Darkone83/XBOX-RGB/README.md

<div align=center>
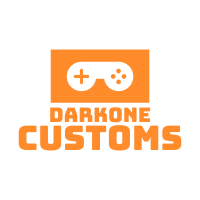
[picture p1: images/DC logo.png]
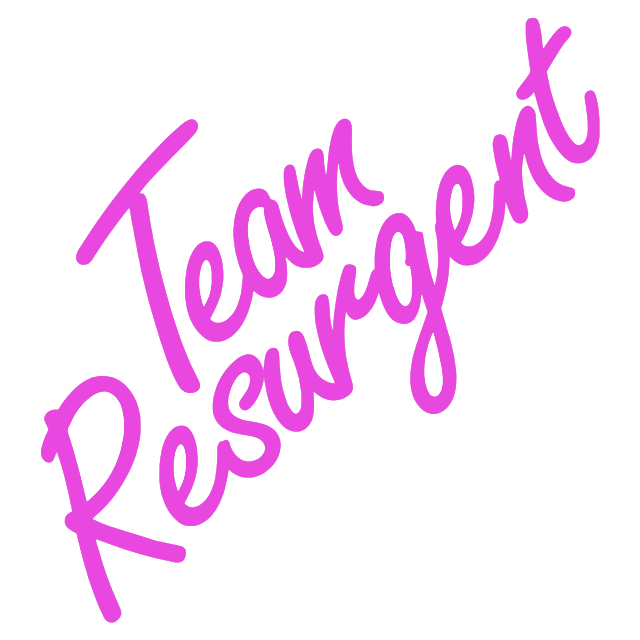
[picture p2: images/team-resurgent.png]
  
</div>

# XBOX RGB 

<div align=center>
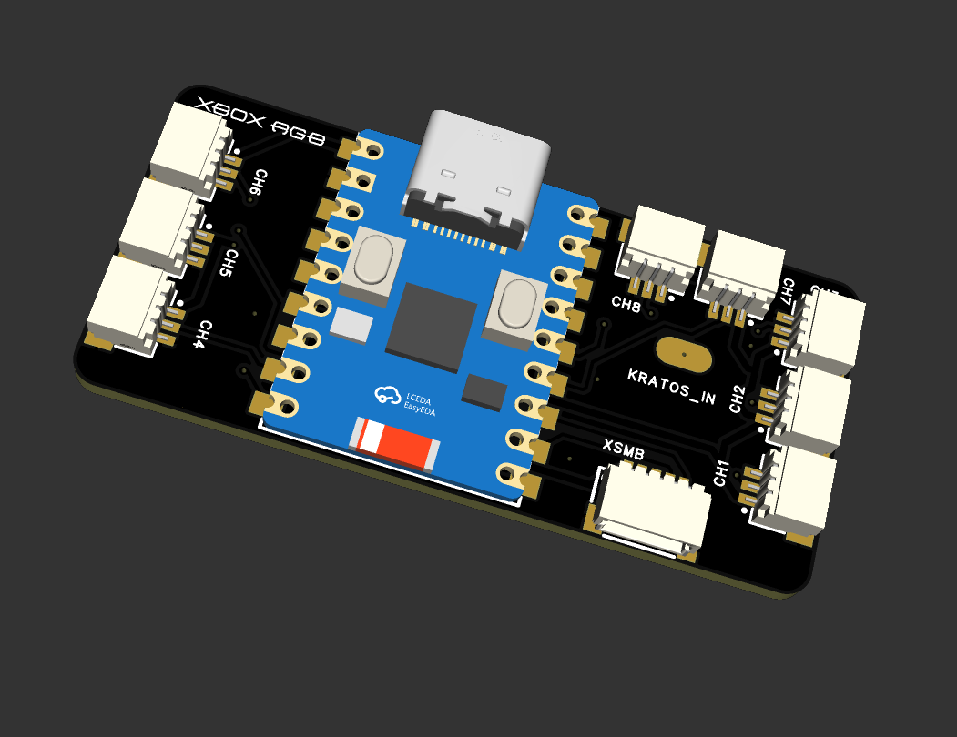
[picture p3: images/3D Front.png]
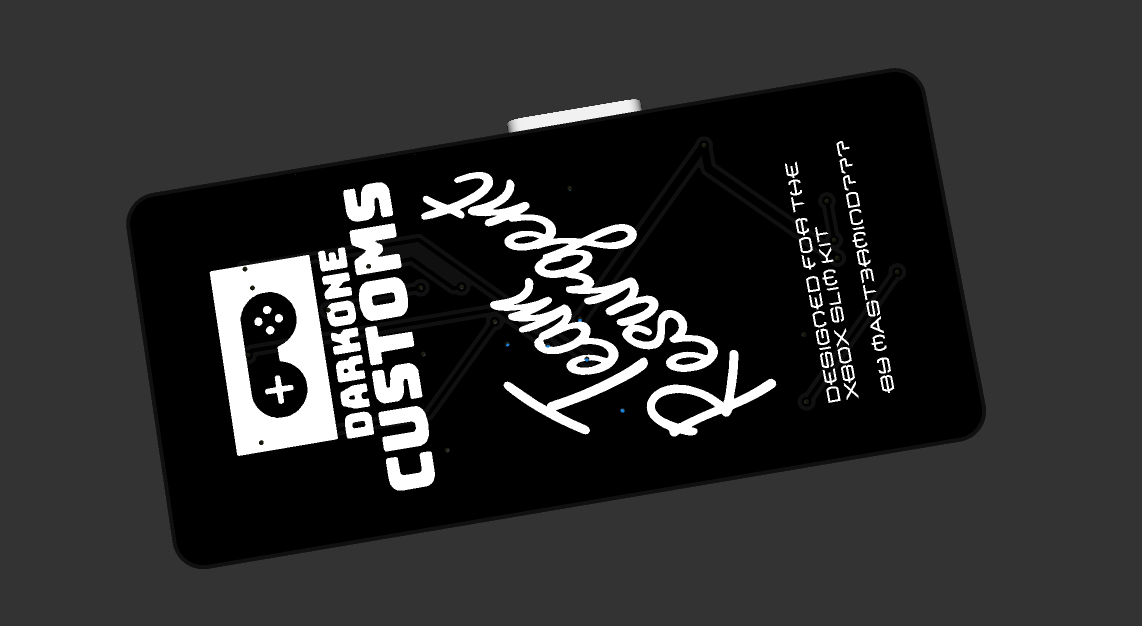
[picture p4: images/3D Back.png]
  

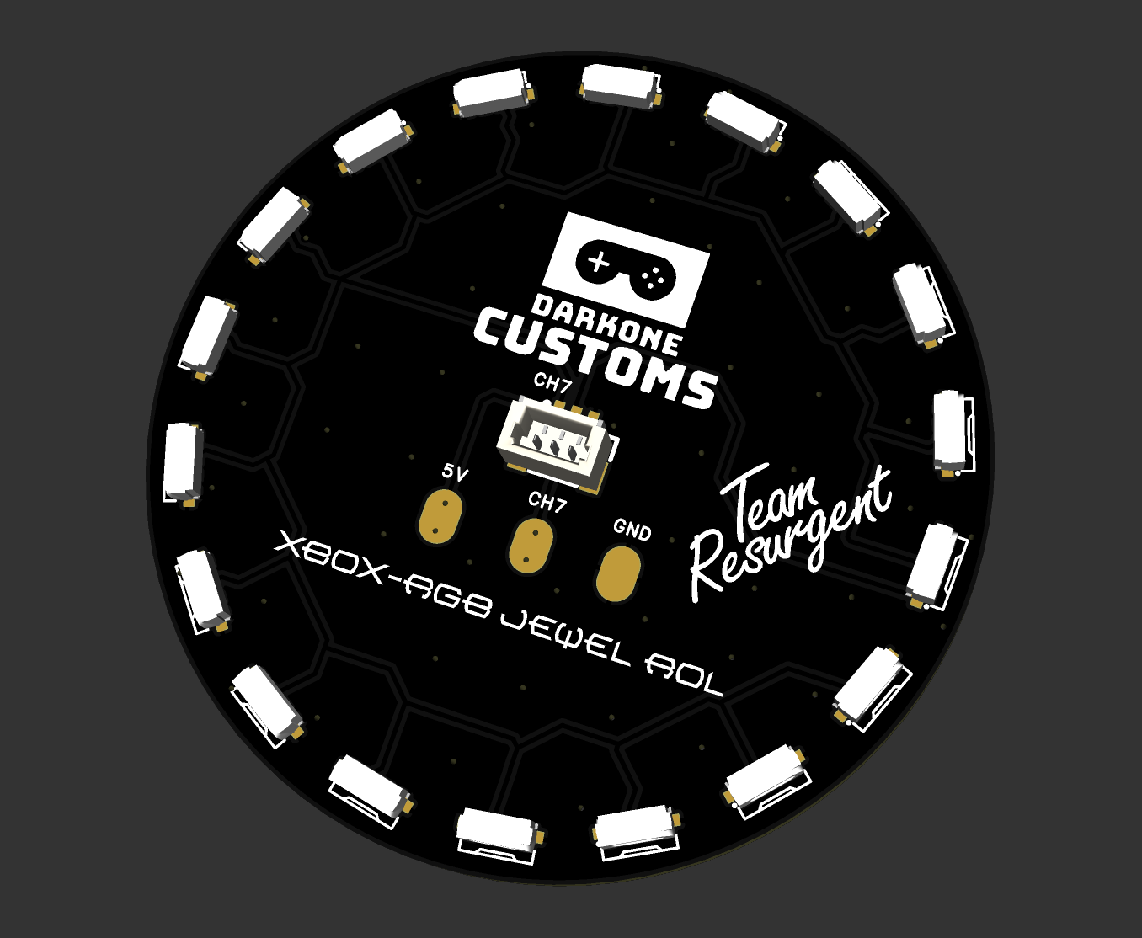
[picture p5: images/3D Jewel Front.png]
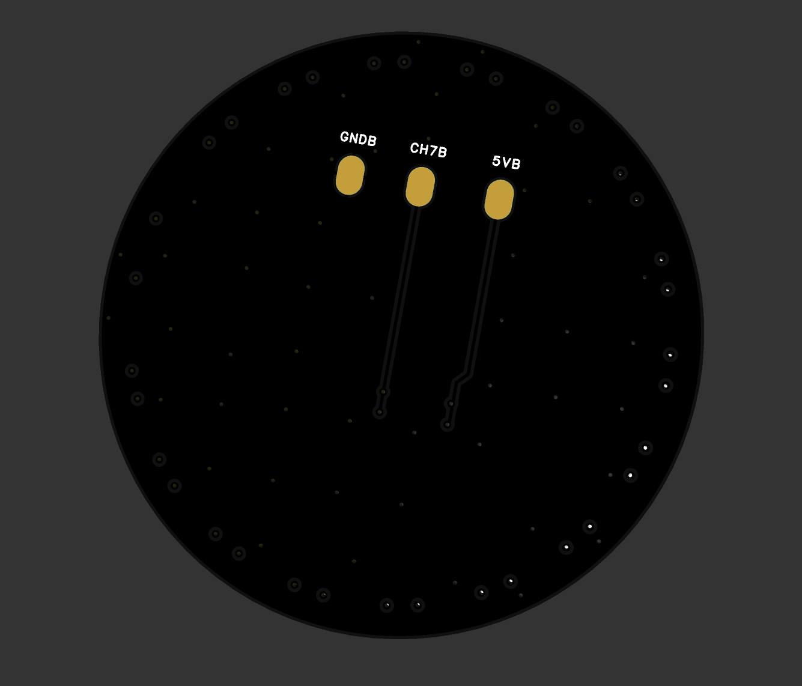
[picture p6: images/3D Jewel Back.png]
  
</div>



A custom RGB controller that drives up to **8 WS2812/NeoPixel channels** for original Xbox RGB lighting — with a **captive-portal Wi-Fi setup**, **web control UI**, **OTA updates**, and optional **Xbox SMBus** telemetry bars for **CPU temperature (CH5)** and **fan speed (CH6)**, **Jewel ROL CH7** and **CH8 for future espansion**.

- **CH1–CH4**: Main LED ring (up to **50 pixels per channel**).  
- **CH5**: CPU temperature bar (up to **10 pixels**).  
- **CH6**: Fan speed bar (up to **10 pixels**). 
- **CH7**: Jewel Ring of Light (ROL) **18 pixels**.
- **CH8**: Future Expansions. 

The web UI previews changes live and saves them to flash (NVS).

## 📱 Get the App

Download on the App Store (https://apps.apple.com/us/app/dc-rgb-control/id6755371794)

Download the **DC RGB Control** app for iOS to configure and manage your Darkone Customs RGB lighting hardware via BLE.

---

## Features

- ✨ **12 animation modes** (see below) with live preview
- 🔆 Global **brightness** (1–255)
-  💡 **Power on fade in** slow but gentle boot fdade in
- ⚙️ Per-mode controls: **Speed**, **Intensity**, **Width/Gap**, **Color A / Color B**
- 🧭 **Sane orientation & sync**: effects start at **CH1 (Front)** and flow clockwise **CH1→CH2→CH3→CH4→CH7→CH8**; all “phase” effects are synchronized
- 🪩 **Adjustable Strip length** CH1 - 4 can support up to 50 LEDs configurable from the webui
- 🔀 **Reversible channel support** Adjust the direction of your channels if you installed them backwards
- 💾 **Persistent settings** in NVS (counts, mode, colors, brightness, toggles…)
- 📶 **Wi-Fi portal** (AP SSID `XBOX RGB Setup`) with a sticky SSID picker
- 🌐 **Web UI** at `/config`
- 🔁 **OTA updates** at `/ota`
- 🧪 **SMBus (Xbox SMC) telemetry** (optional, on CH5/CH6)
  - **CPU temperature** bar (green→yellow→red, max 75 °C)
  - **Fan percentage** bar (blue→yellow→orange)
- 🛜 **UDP control** UDP comminucation and control for XBMC4Gamers and the PC app
- 🛜 **BLE control** BLE support for configuration and control (experemental).

---

## Animation Modes

1. **Solid**  
2. **Breathe** *(synced across all channels)*  
3. **Color Wipe**  
4. **Larson Scanner (Cylon)**  
5. **Rainbow** *(synced progression around the ring)*  
6. **Theater Chase**  
7. **Twinkle**  
8. **Comet**  
9. **Meteor** *(Color A→Color B trail)*  
10. **Clock Spin**  
11. **Plasma**  
12. **Fire / Flicker**
13. **Palette Cycle**
14. **Palette Chase**
15. **USNC <-> Covenant** **NEW**

> The UI only shows controls that matter for the selected mode.  
> Example: *Meteor* uses **Color A** and **Color B**; *Breathe* ignores **width**.

---

## Purchase:

<a href="https://www.darkonecustoms.com/store/p/xbox-rgb">Darkone Custsoms</a>

---

## Hardware

## Purchasing sources

ESP32 S3 Zero: <a href="https://www.amazon.com/dp/B0D1CB3PBW?ref_=ppx_hzsearch_conn_dt_b_fed_asin_title_1">Amazon</a>, <a href="https://www.aliexpress.us/item/3256808233319699.html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">Aliexpress</a>

JST Wire kit: <a href="https://www.amazon.com/dp/B0D5X6BY5Z?ref_=ppx_hzsearch_conn_dt_b_fed_asin_title_1">Amazon</a>

JST Socket kit: <a href="amazon.com/dp/B0CQ28CCQG?ref_=ppx_hzsearch_conn_dt_b_fed_asin_title_2">Amazon</a>

Additional wire may be needed to connect your harness to your LED strips.

## Hardware layout

Designed around **ESP32-S3-Zero** (or similar ESP32-S3 boards).

**Typical channel mapping** (adjust in code if needed):

- **CH1** → `IO1` (Front)  
- **CH2** → `IO2` (Left)  
- **CH3** → `IO3` (Rear)  
- **CH4** → `IO4` (Right)  
- **CH5** → `IO5` (CPU bar)  
- **CH6** → `IO6` (Fan bar)
- **CH7** → `IO10` (Jewel ROL)
- **Kratos_In** → `IO11` (Kratos Passthrough (Future Expansion))
- **CH8** → `IO12` (Future Expansions)

**SMBus (Xbox SMC I²C):**

- **SDA** → `IO7`  
- **SCL** → `IO8`

> If a strip is reversed physically, flip that channel via the `REVERSE[]` flags in `RGBCtrl.cpp`, or the WebUi.

---

## Pinouts

CH1 - 3:

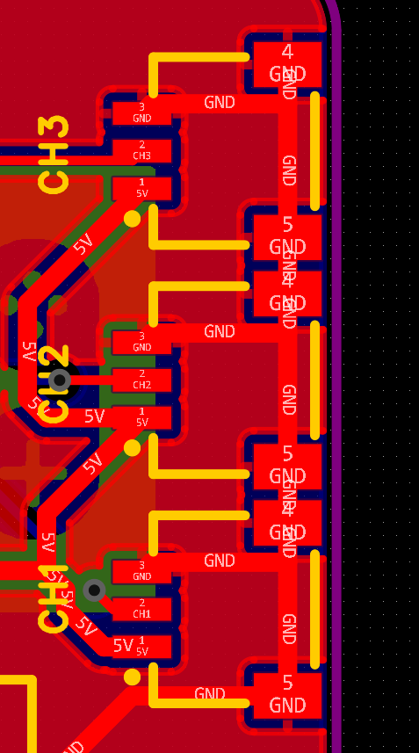
[picture p7: images/CH1-3.png]


Ch4 - 8:

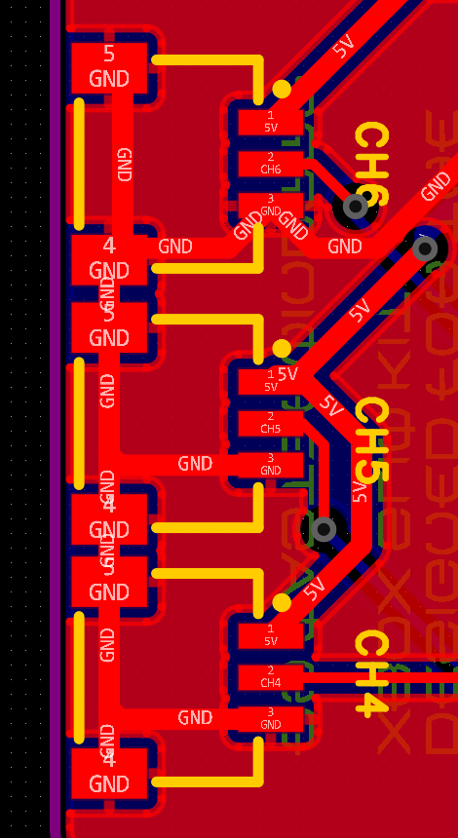
[picture p8: images/CH4-6.png]


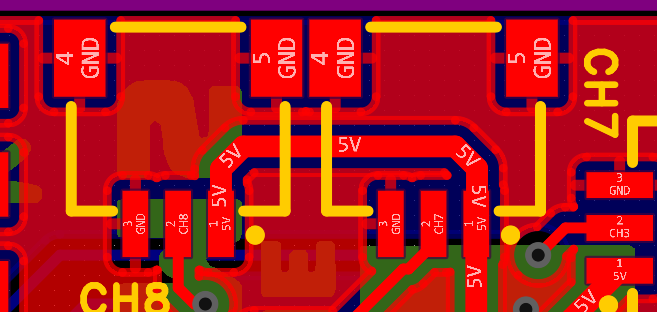
[picture p9: images/CH7-8.png]


XSMB:

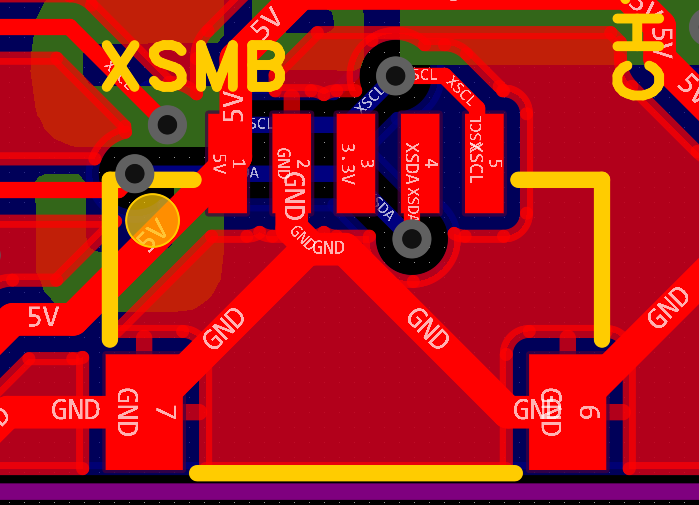
[picture p10: images/XSMB.png]


---

## Web UI

- Visit **`/config`** on the device to control animations.  
- **Live preview** applies instantly; **Save** writes to flash.  
- SMBus toggles (Enable CPU / Enable Fan) live under “Xbox SMBus LEDs”.

**Captive Portal:**  
On first boot (or after forgetting Wi-Fi) connect to AP **`XBOX RGB Setup`** → it redirects to the setup page.

**OTA:**  
Open **`/ota`**, pick your compiled `.bin`, upload, wait for reboot.

---

## Building / Compiling

#### Web Flasher: 

### Prerequisites

- **Arduino IDE 2.x** (or PlatformIO)
- **ESP32 board support** (Arduino-ESP32 **3.x**)
- Libraries:
  - **ESP Async WebServer** (me-no-dev)
  - **AsyncTCP** (ESP32)
  - **Adafruit NeoPixel**
  - **ArduinoJson**
  - Core: **Preferences**, **DNSServer**, **Update**

> Ensure AsyncTCP matches the ESP32 core version (latest works with Arduino-ESP32 3.x).

### Board Settings (typical)

- **Board:** `ESP32S3 Dev Module` (or your S3 variant)  
- **USB CDC On Boot:** Enabled  
- **PSRAM:** Optional  
- **Partition Scheme:** Minimal SPIFFS (1.9MB APP with OTA/190KB SPIFFS)

## Credits:
Hardware design: darkone83

Firmware: darkone83

3D Design / STLs: mast3rmind777

iOS App: darkone83

Android App: TechPhreak
