Darkone83/XBOX-RGB/stl/Readme.md

# XBOX-RGB Mount

STL creation and credit goes to Mast3rmind777
