Darkone83/XBOX-RGB/images/Back.png

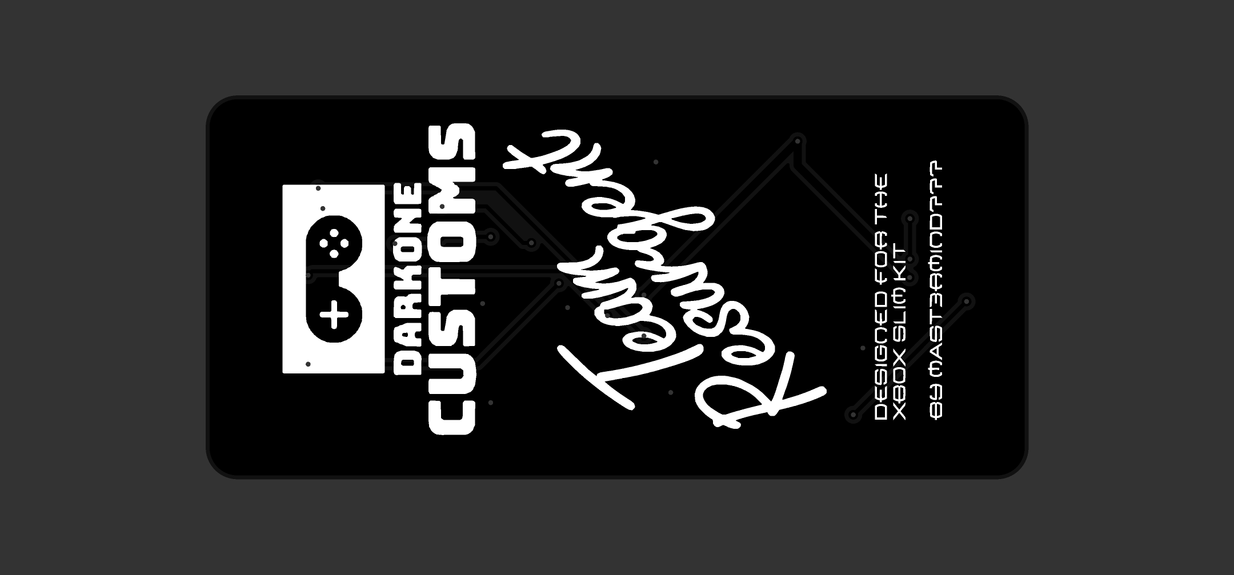
images/Back.png
