Darkone83/XBOX-RGB/images/Front.png

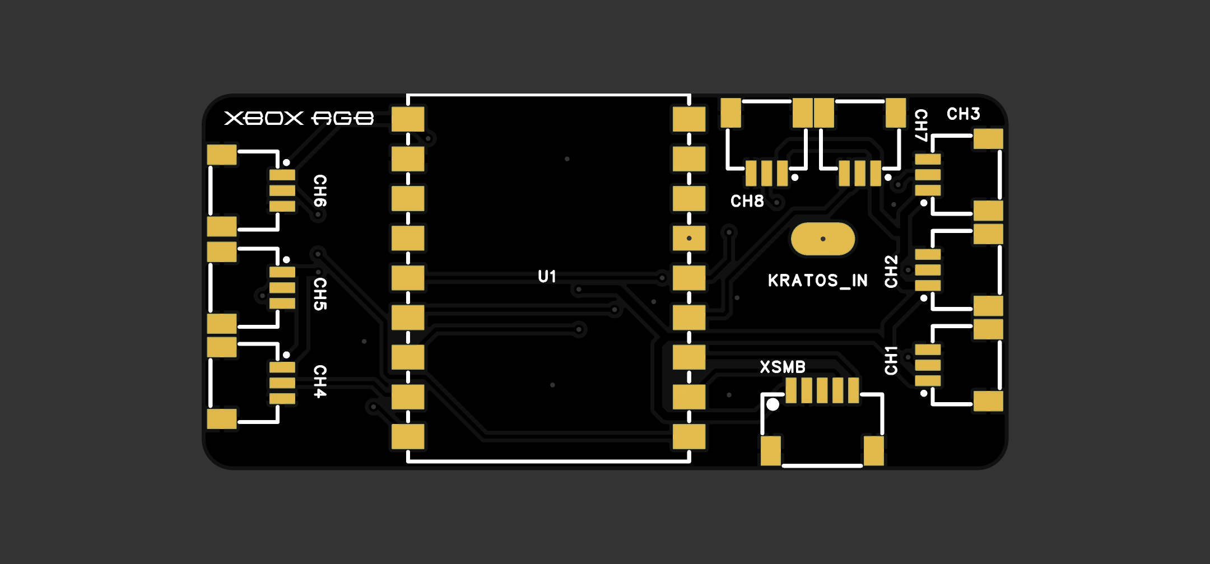
images/Front.png
