Darkone83/XBOX-RGB/images/Jewel Back.png

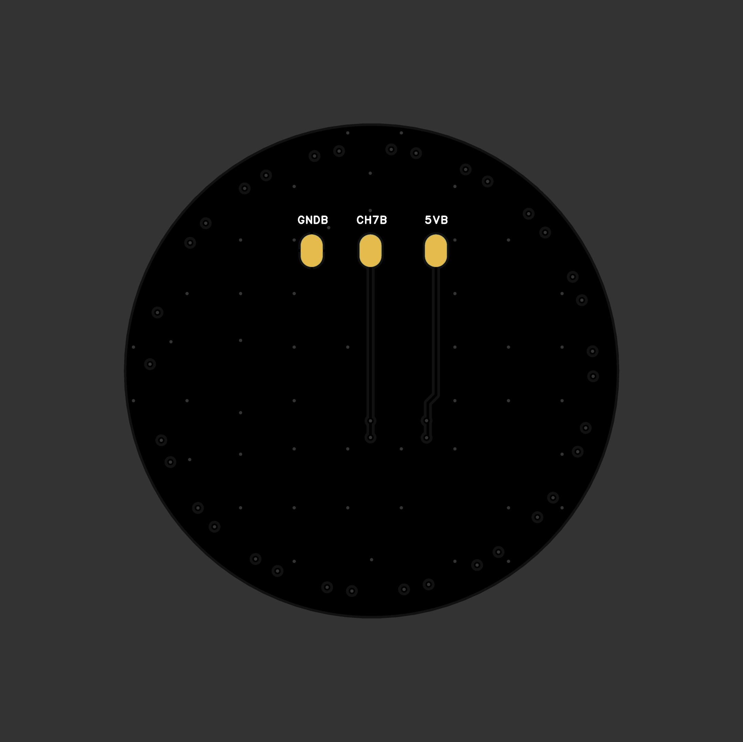
images/Jewel Back.png
