Darkone83/XBOX-RGB/images/Jewel Front.png

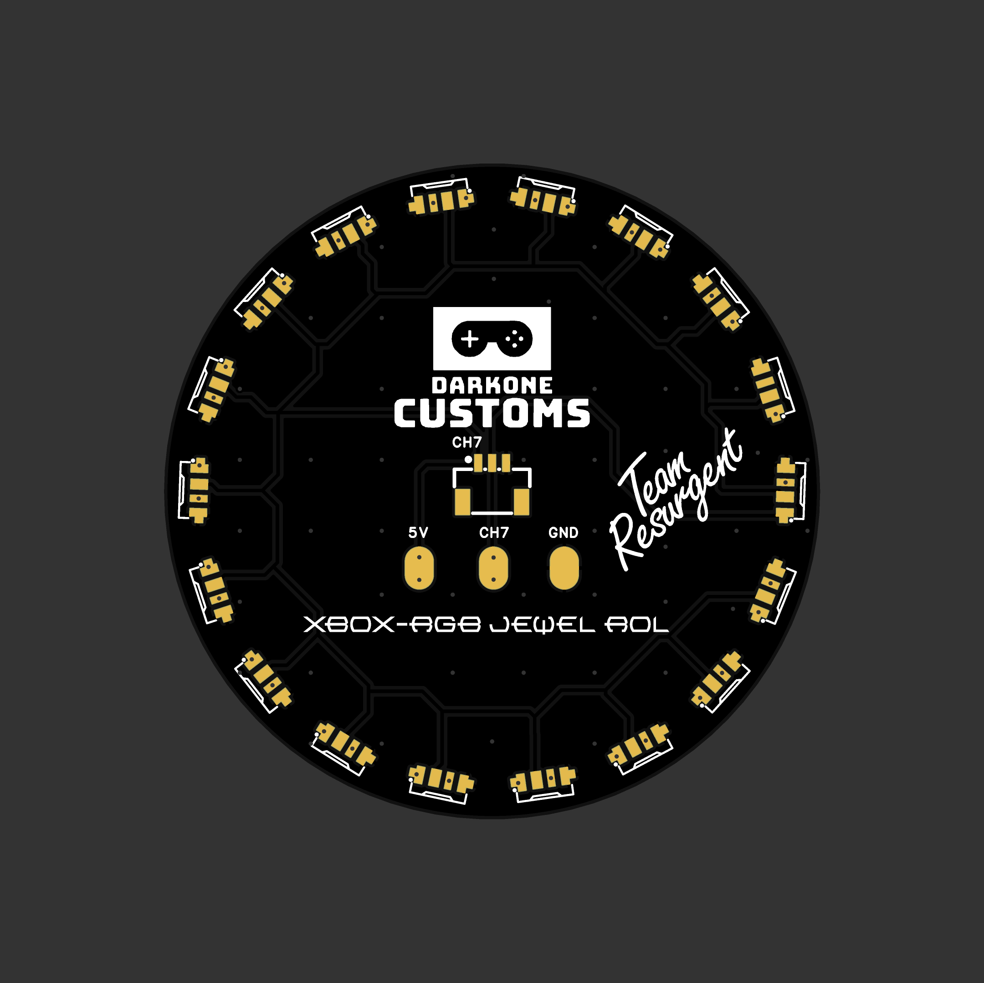
images/Jewel Front.png
