Darkone83/XBOX-RGB/jewel pcb/BOM.xlsx

No. | Quantity | Comment | Designator | Footprint | Value | Manufacturer Part | Manufacturer | Supplier Part | Supplier
1 | 6 | Test-Point | 5V,5VB,CH7,CH7B,GND,GNDB | Test-Point-0.5mm
2 | 1 | HC-1.0-3PLT | CH7 | CONN-SMD_3P-P1.00_HC-1.0-3PLT |  | HC-1.0-3PLT | HCTL(华灿天禄) | C2845371 | LCSC
3 | 18 | SK6812SIDE-A-RVS | RGB_LED1,RGB_LED2,RGB_LED3,RGB_LED4,RGB_LED5,RGB_LED6,RGB_LED7,RGB_LED8,RGB_LED9,RGB_LED10,RGB_LED11,RGB_LED12,RGB_LED13,RGB_LED14,RGB_LED15,RGB_LED16,RGB_LED17,RGB_LED18 | LED-SMD_4P-L4.0-W1.6-L |  | SK6812SIDE-A-RVS | 欧思科光电 | C2890037 | LCSC
