Darkone83/XBOX-RGB/pcb/BOM.xlsx

No. | Quantity | Comment | Designator | Footprint | Value | Manufacturer Part | Manufacturer | Supplier Part | Supplier
1 | 8 | IPCW100W13NWS1R | CH1,CH2,CH3,CH4,CH5,CH6,CH7,CH8 | CONN-SMD_3P-P1.00_INCP_IPCW100W13NWS1R |  | IPCW100W13NWS1R | INCP | C4943258 | LCSC
2 | 1 | Test-Point | KRATOS_IN | Test-Point-0.5mm
3 | 1 | ESP32-S3-Zero | U1 | COMM-SMD_18P-P2.54-L23.5-W18.0-TL |  | ESP32-S3-Zero |  | C9900152785 | LCSC
4 | 1 | XDWF-0910-05P | XSMB | CONN-SMD_XDWF-0910-05P |  | XDWF-0910-05P | LX(连欣科技) | C7527620 | LCSC
