Darkone83/XBOX-RGB/stl/RGB Mount v0.stl

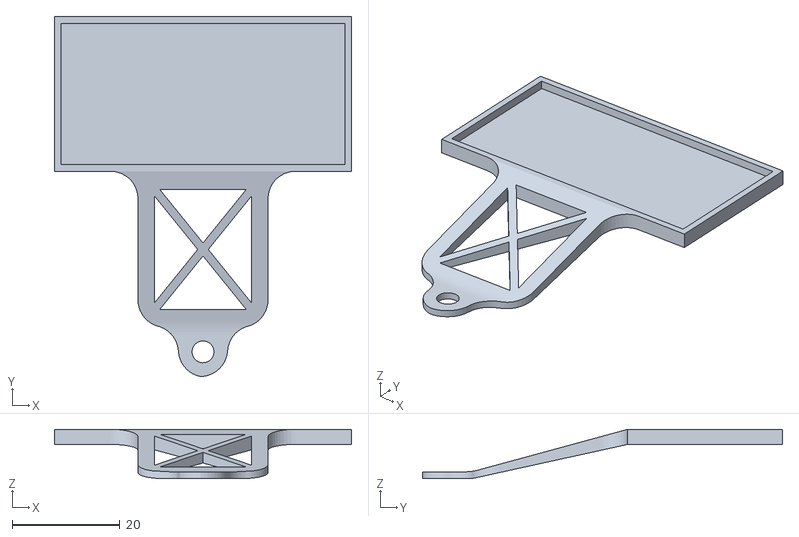
[picture p15: CAD file, 2025-11-16]
stl/RGB Mount v0.stl
55.1 x 66.8 x 9.14
