Darkone83/XBOX-RGB/docs/OGX install/Readme.md

# Original XBOX Install images

In the images folder are recommended wiring and installation images for reference
