Darkone83/XBOX-RGB/docs/XBOX RGB Install.pdf

# XBOX RGB Install Guide and Usage Instructions

## Installation:

Installation of XBOX RGB is fairly straightforward and can be unique to each person's XBOX or use case. Below are some general guidelines. Please note that wiring harness colors may be nonstandard and you should review the port layouts to confirm.

XBOX-RGB ROL Notes:

If your installing an XBOX-RGB ROL on your V1 or V2 board ensure you are running the latest firmware (1.8.0 or greater). Connect 5V to pin 1 of the ESP32, connect GND to pin 2of the ESP32, and connect CH7 to pin 13 or GPIO10 of the ESP32.

Required tools:

Multi-meter
Wire: AWG 28 or 30GA
Soldering Iron
Double-sided tape
Heat shrink tubing (optional)
WS2812 LEDs (if you use your own LED strips)

Port Pinouts:

CH1 – 8:

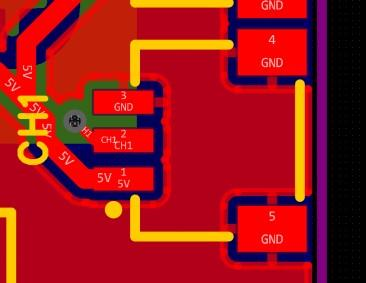
[picture p16: figure]

XSMB:

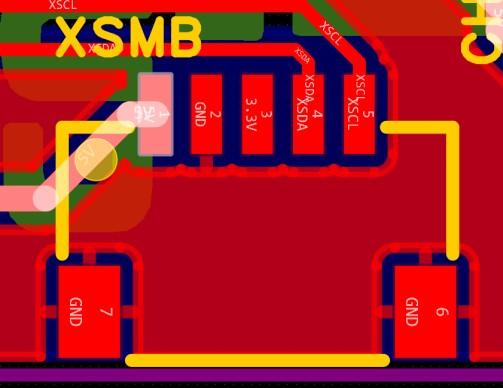
[picture p17: figure]

V1 Notes:

V1 had a different connector layout from the production boards they will have CH1, CH2/3, CH4, CH5, and CH6.

V1 harness colors are as follows:

CH1, CH4, CH5 CH6:

Green: 5V
Yellow: RGB
Brown: GND

CH2/3:

Green: 5V
Yellow: RGB CH2
Blue: RGB CH3
Brown: GND

XSMB:

Red: 5V
Black: GND
Blue: SDA
White: SCL

V2 Notes:

V2 is the production board and the pinouts are as follows:

CH1, CH2, CH3, CH4, CH5, CH6

Yellow: 5V
Black: RGB
Red: GND

XSMB:

Blue: 5V
Green: GND
White: 3.3V (Not Used)
Black: SDA
Red: SCL

V3 Notes:

V3 is the current board with some features, here are the new additions:

CH1, CH2, CH3, CH4, CH5, CH6, CH7, CH8

Yellow: 5V
Black: RGB
Red: GND

XSMB:

Blue: 5V
Green: GND
White: 3.3V (Not Used)
Black: SDA
Red: SCL

Kratos_In is a test pad for future expansion

XBOX RGB only needs 5V and GND to function, and these can be tapped from a few sources. Use your multimeter to probe for a viable 5V source. SDA and SCL are required for the proper function of CH5 and CH6 if you choose to install those. SDA can be tapped from PIN14 and SCL from PIN13 of the VBOX LPC. You could even grab 5V and GND from there as well. For XBOX 1.6/b users DO NOT tap 5V from the LPC as your XBOX RGB kit will always be on. Below are examples of LCP pinouts and an ALT 5V point for 1.6/b XBOX’s

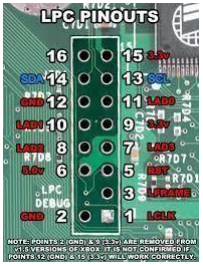
[picture p18: figure]

## Connecting to WiFi:

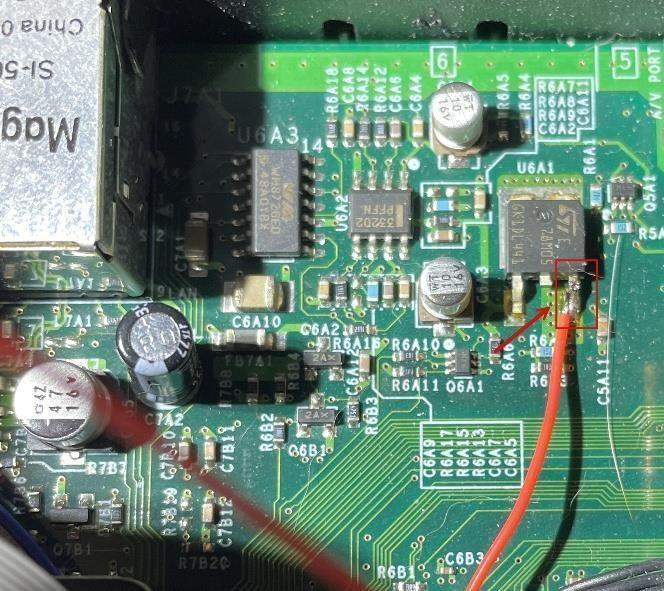
[picture p19: figure]

After installing your XBOX RGB kit and on its first power up it will broadcast a WiFi network called XBOX RGB Setup. You can do a few things here to don’t ever have to join it to your network if you don’t want to, as tou can tap on Open Config to hop right into the config menu and use it standalone.

1. Tap on XBOX RGB Setup

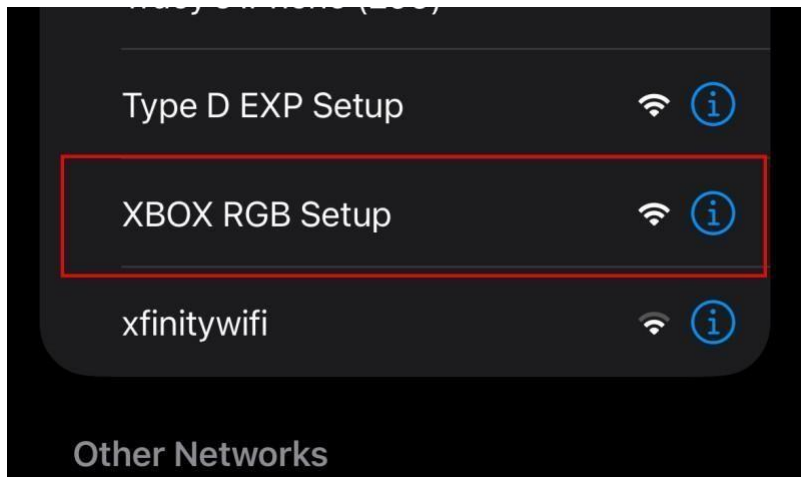
[picture p20: figure]

2. Tap on the No networks found section of WiFi networks

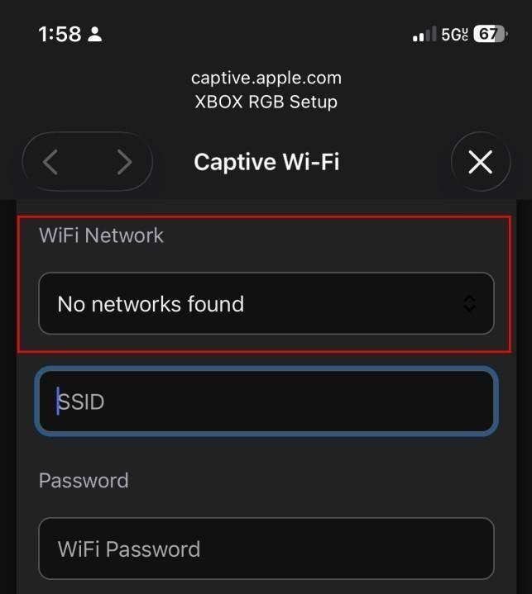
[picture p21: figure]
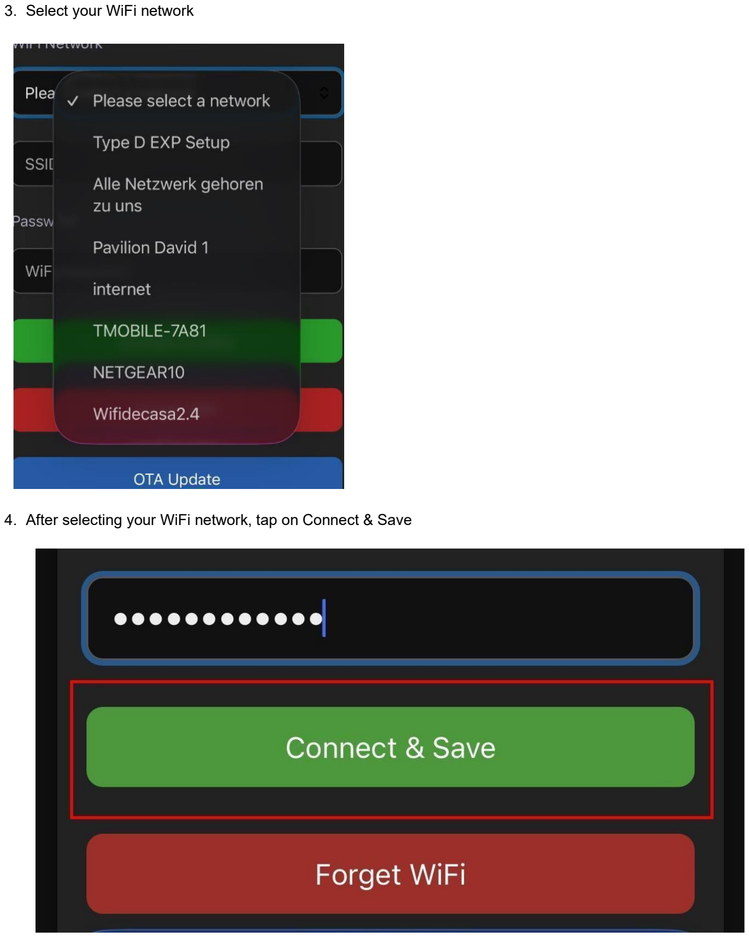
[picture p22: page 6]

3. Select your WiFi network
4. After selecting your WiFi network, tap on Connect & Save

## Configuring your device:

To configure XBOX RGB, simply open a web browser and visit HTTP://xboxrgb.local. Once open tap on Open Config.

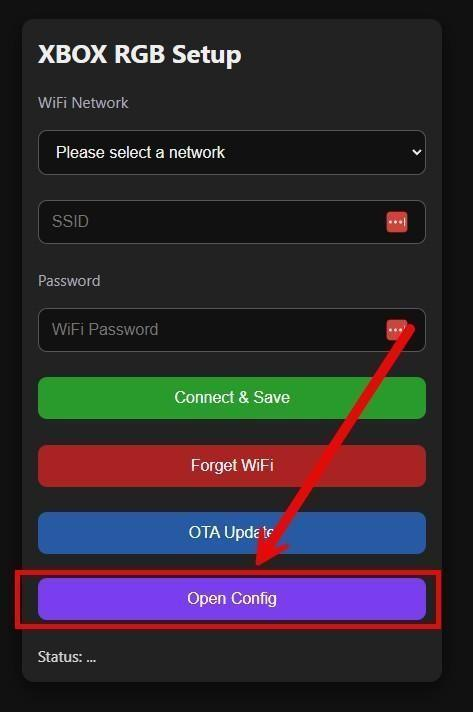
[picture p23: figure]

## Configuration Overview:

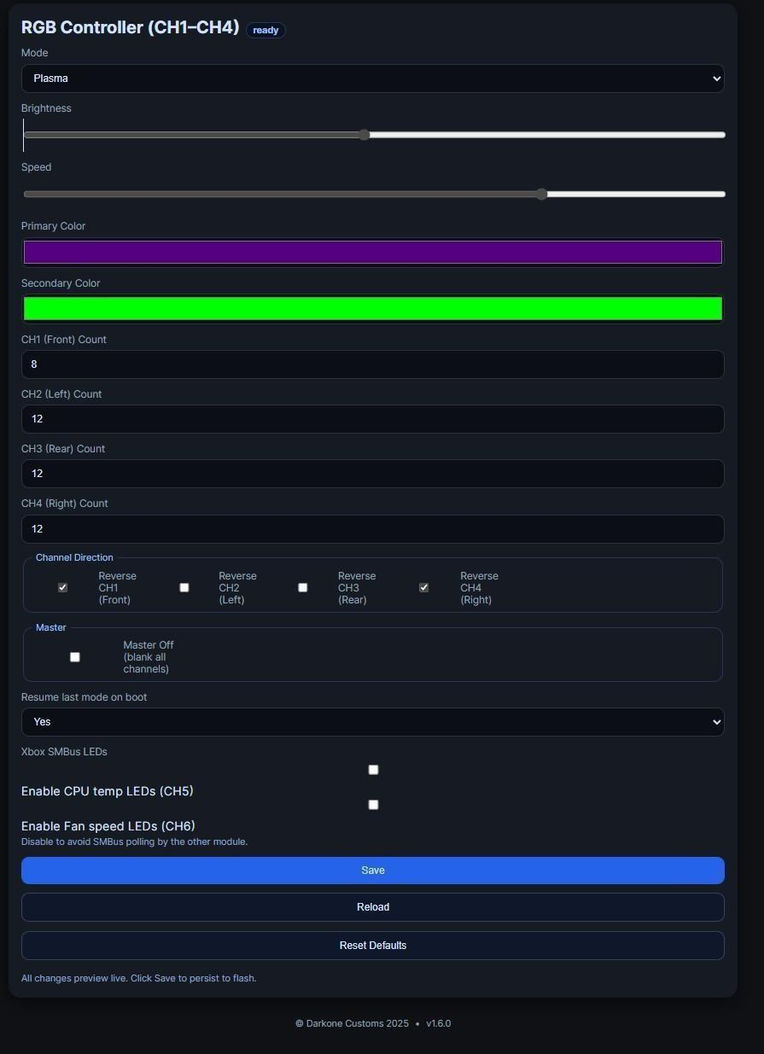
[picture p24: figure]

On the main configuration page, you have full control of XBOX RGB. Some key things to remember: you will preview modes instantly if you like a mode tap on save to save the settings. XBOX RGB will reload those settings on boot. You have to define your LEDs per channel. CH 1 – 4 can have a max of 50 LEDs per channel. If you install a strip backwards, you can reverse the direction of an individual channel in the config, Larson or Clock Spin are good animations to ensure you have good direction. Animations flow from left to right so CH 1 to 2 then to 3 etc.

## Animation modes:

Solid
Breathe (synced across all channels)

Color Wipe

Larson Scanner (Cylon)

Rainbow (synced progression around the ring)

Theater Chase

Twinkle

Comet

Meteor (Color A→Color B trail)

Clock Spin

Plasma

Fire / Flicker

Palette Cycle

Palette Chase

Custom (Playlist) [You can string together animations in a playlist style]

USNC <-> Covenant

An additional feature of XBOX RGB is CH5 (CPU Temp) and CH6 (Fan Speed). These are optional, and to use them, you will need to wire SDA and SCL on the XSMB harness. If you have a Type D Expansion unit installed, these features will not work.

## Additional ways to configure:

XBOX RGB also has a companion PC app along with an XBMC4Gamers script if you choose to use those. Those are available for free download on our github: https://github.com/Darkone83/XBOX-RGB.

## Features:

- ✨ 12 animation modes (see below) with live preview
- 🔆 Global brightness (1–255)
- 💡 Power on fade in slow but gentle boot fdade in
- ⚙️ Per-mode controls: Speed, Intensity, Width/Gap, Color A / Color B
- 🧭 Sane orientation & sync: effects start at CH1 (Front) and flow clockwise

CH1→CH2→CH3→CH4; all “phase” effects are synchronized

- 🧭 Adjustable Strip length CH1 - 4 can support up to 50 LEDs configurable from the webui
- 🔀 Reversible channel support Adjust the direction of your channels if you installed them

backwards

- 💾 Persistent settings in NVS (counts, mode, colors, brightness, toggles…)
- 📶 Wi-Fi portal (AP SSID XBOX RGB Setup) with a sticky SSID picker
- 🌐 Web UI at /config
- 🔁 OTA updates at /ota
- 🧭 SMBus (Xbox SMC) telemetry (optional, on CH5/CH6) o CPU temperature bar

(green→yellow→red, max 75 °C) o Fan percentage bar (blue→yellow→orange)

- 🧭 UDP control UDP comminucation and control for XBMC4Gamers and the PC app
