Darkone83/XBOX-RGB/docs/OGX install/images/5V.jpg

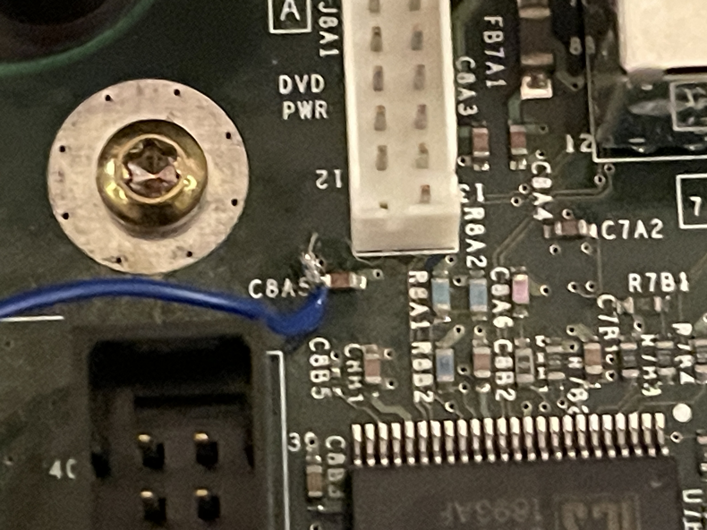
docs/OGX install/images/5V.jpg
