Darkone83/XBOX-RGB/docs/OGX install/images/CH1.jpg

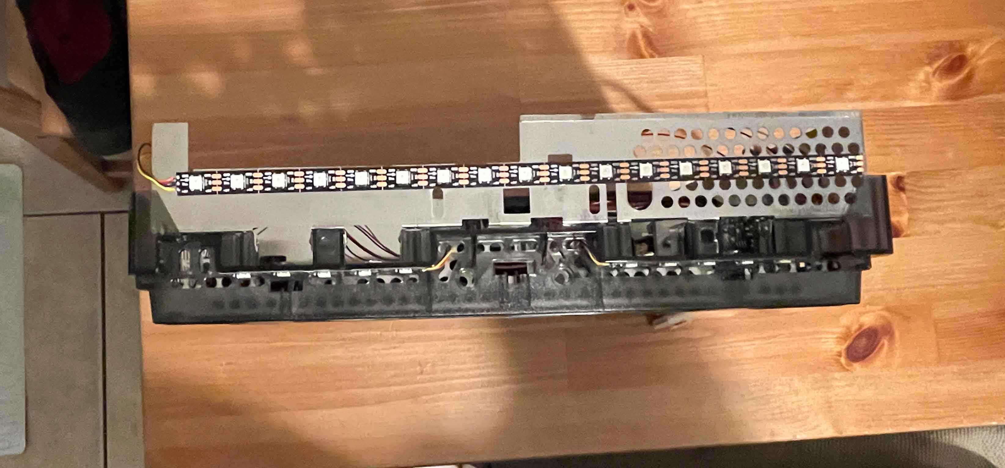
docs/OGX install/images/CH1.jpg
