Darkone83/XBOX-RGB/docs/OGX install/images/CH2.jpg

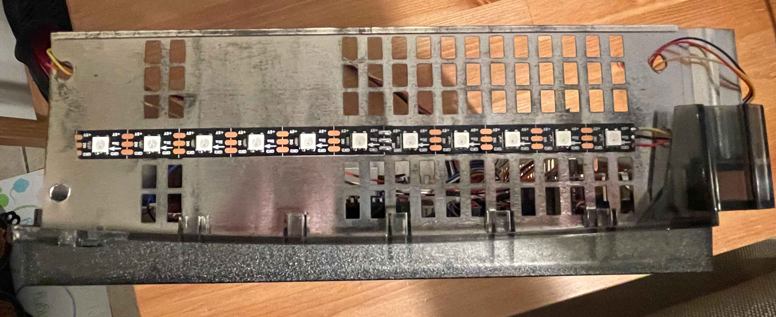
docs/OGX install/images/CH2.jpg
