Darkone83/XBOX-RGB/docs/OGX install/images/CH3.jpg

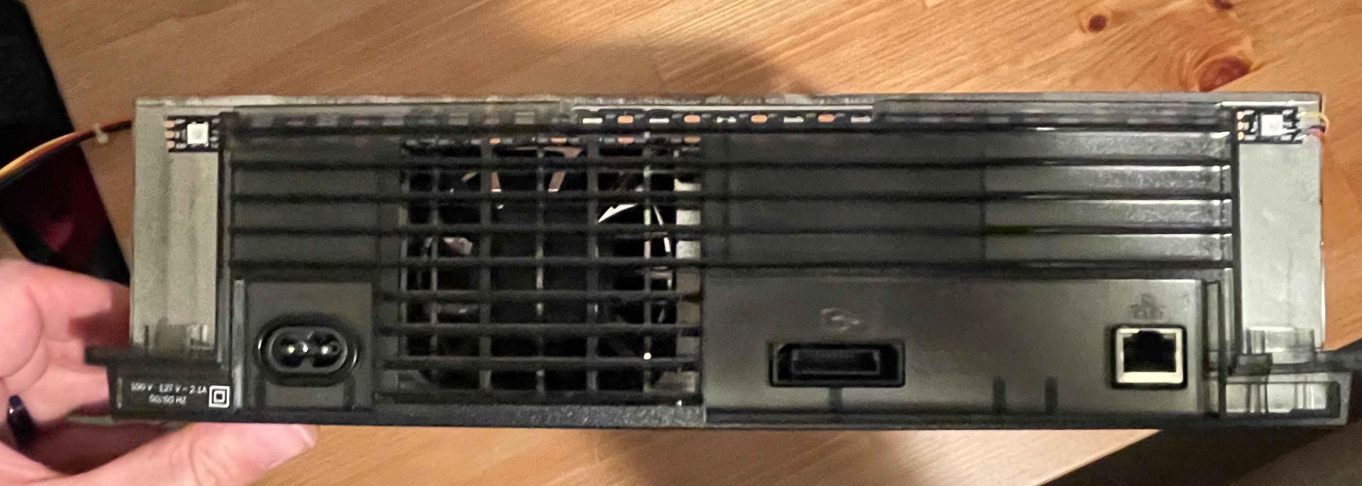
docs/OGX install/images/CH3.jpg
