Darkone83/XBOX-RGB/docs/OGX install/images/CH4.jpg

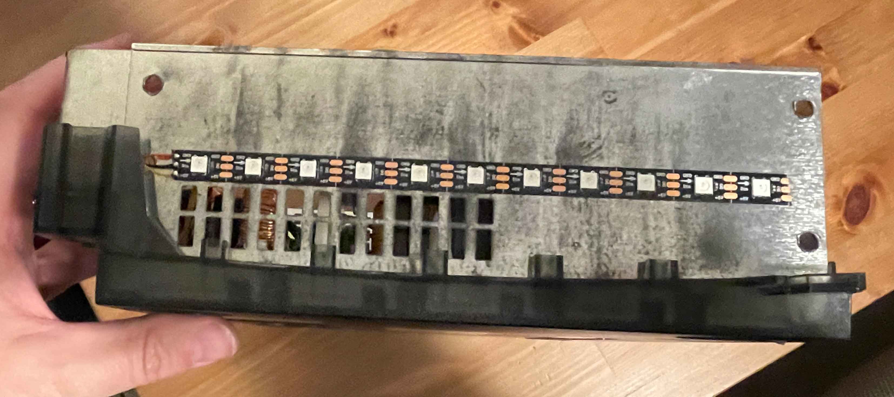
docs/OGX install/images/CH4.jpg
