Darkone83/XBOX-RGB/docs/OGX install/images/CH5-CH6 Wire Route.jpg

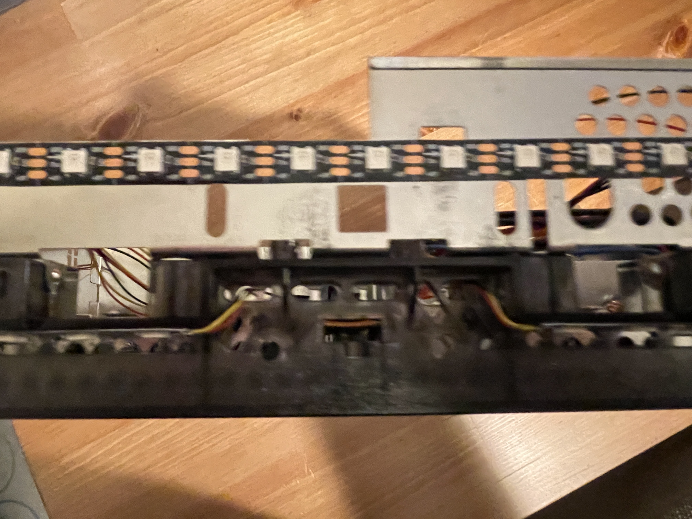
docs/OGX install/images/CH5-CH6 Wire Route.jpg
