Darkone83/XBOX-RGB/docs/OGX install/images/CH5-CH6.jpg

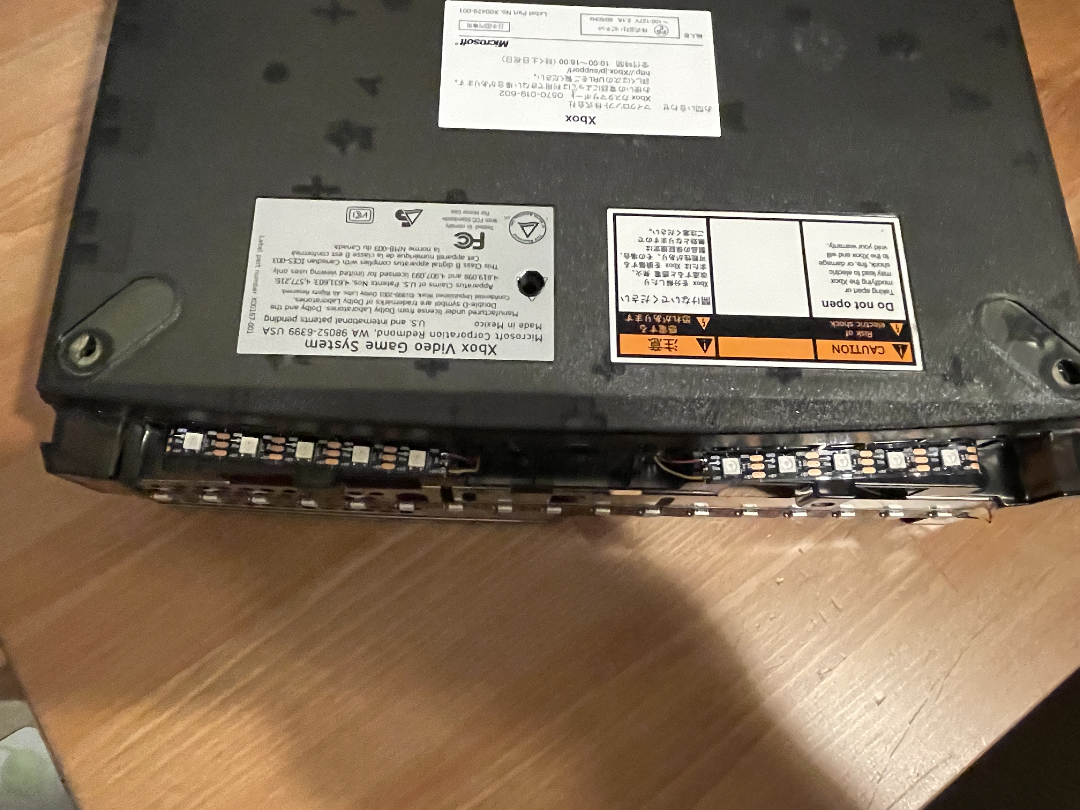
docs/OGX install/images/CH5-CH6.jpg
