Darkone83/XBOX-RGB/docs/OGX install/images/GND.jpg

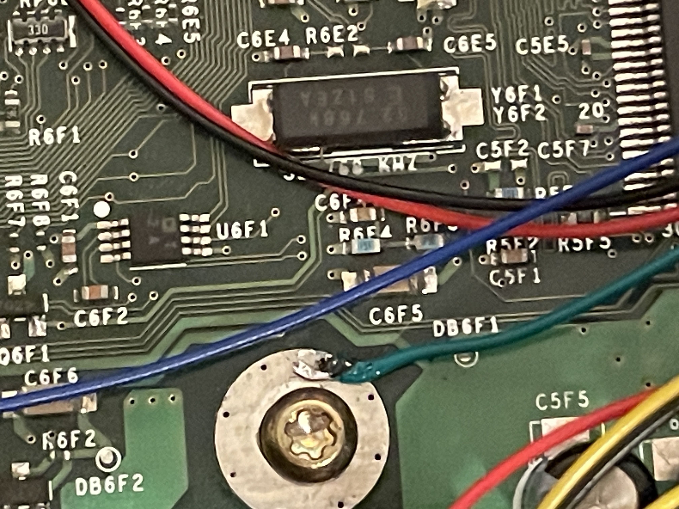
docs/OGX install/images/GND.jpg
