Darkone83/XBOX-RGB/docs/OGX install/images/Install 3D Printd bracket.jpg

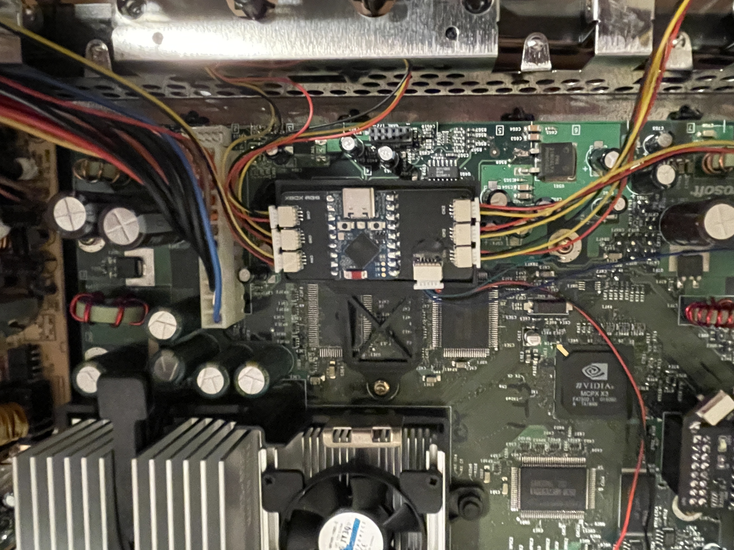
docs/OGX install/images/Install 3D Printd bracket.jpg
