Darkone83/XBOX-RGB/docs/OGX install/images/Motherboard.jpg

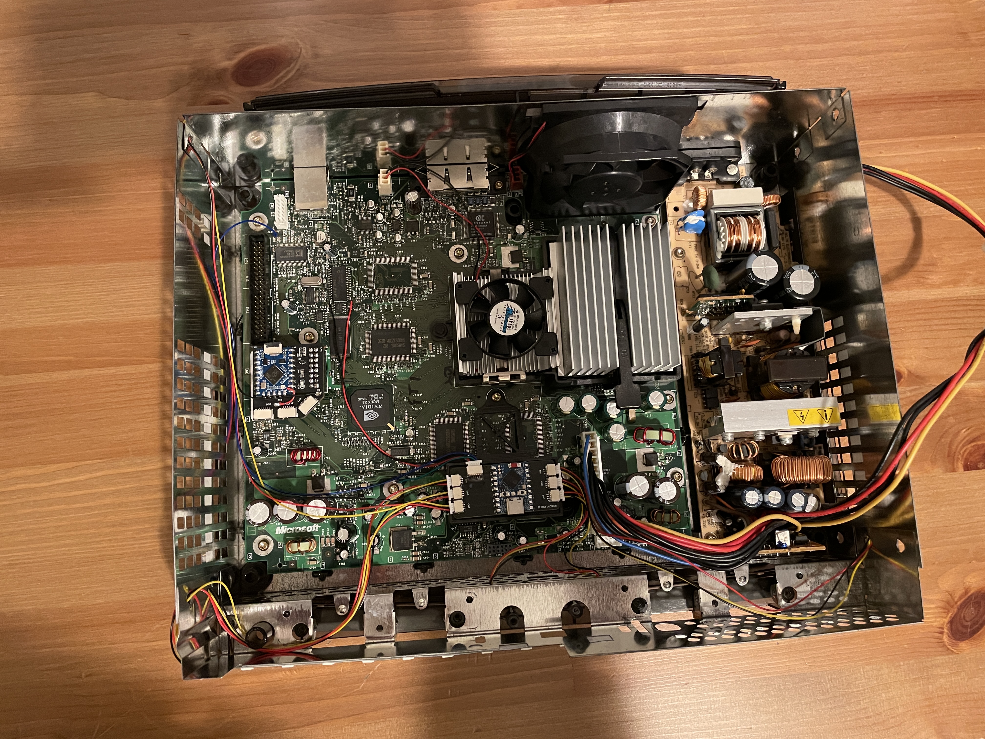
docs/OGX install/images/Motherboard.jpg
