Darkone83/XBOX-RGB/docs/OGX install/images/SDA-SCL 1.0-1.4.jpg

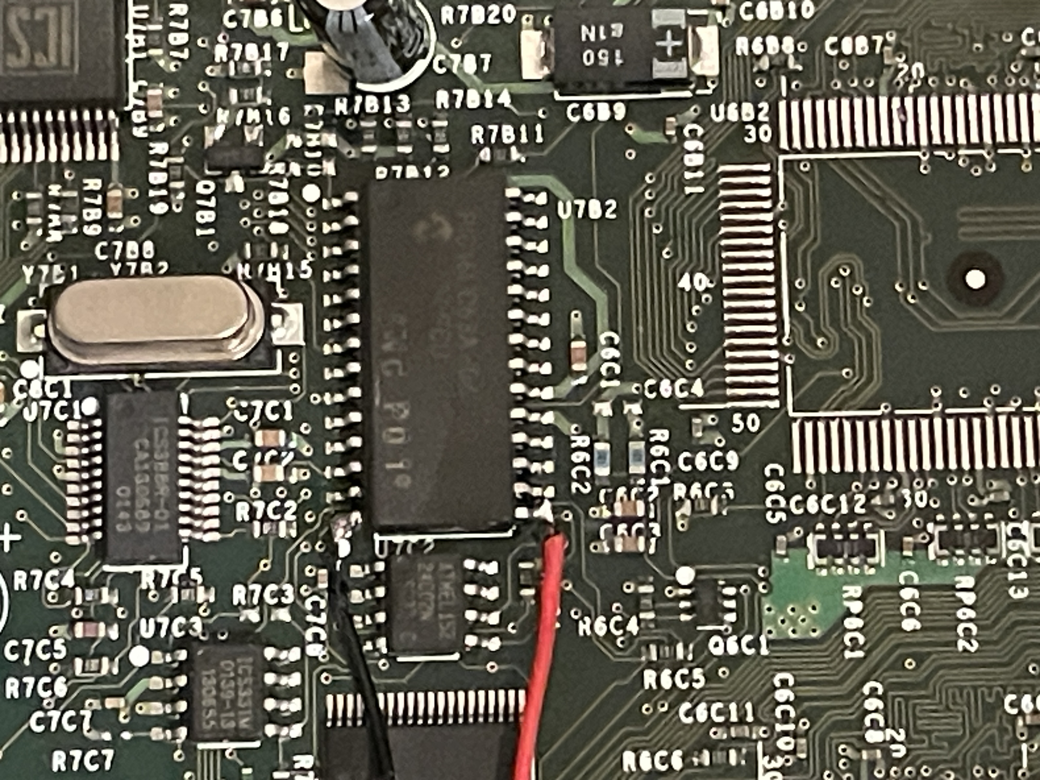
docs/OGX install/images/SDA-SCL 1.0-1.4.jpg
