Darkone83/XBOX-RGB/jewel pcb/Schematic.pdf

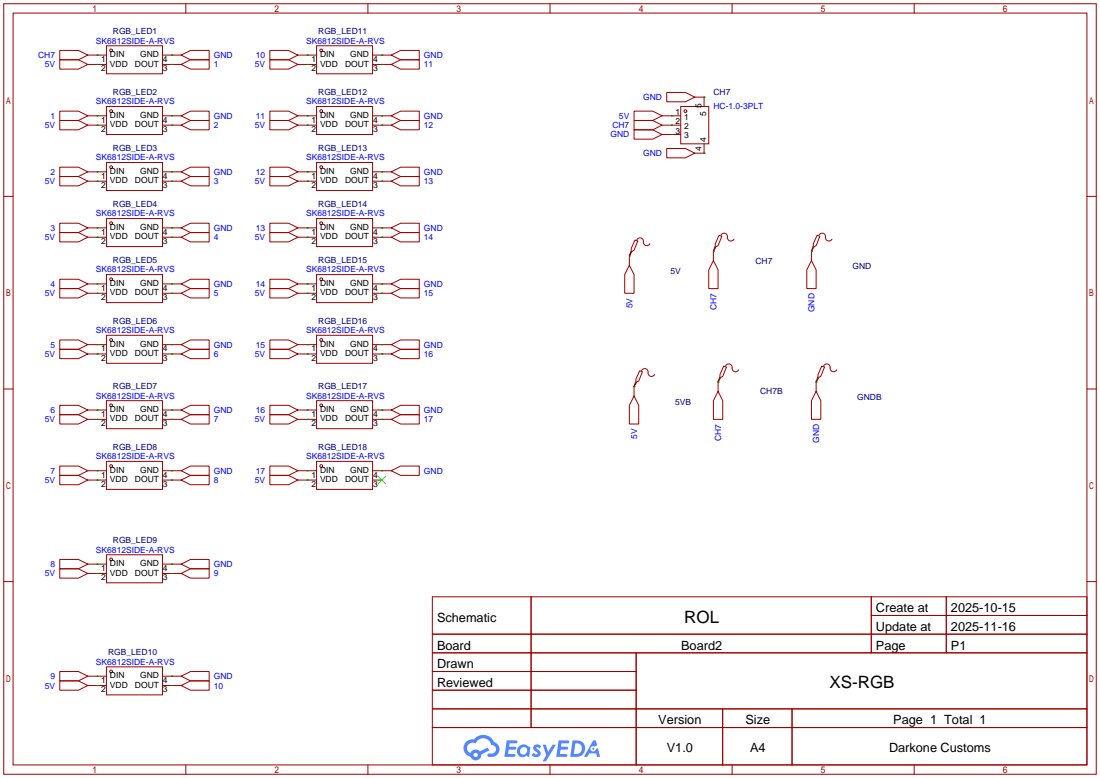
[picture p36: page 1]

Schematic | ROL | Create at | 2025-10-15

Update at | 2025-11-16

Board | Board2 | Page | P1
Drawn | | XS-RGB
Reviewed

Version | Size | Page 1 Total 1
V1.0 | A4 | Darkone Customs
