Darkone83/XBOX-RGB/pcb/Schematic.pdf

# IO7 10 IO8 11 IO9 12 IO10 13 IO11 14 IO12 15 IO13 16 RX 17 TX 18

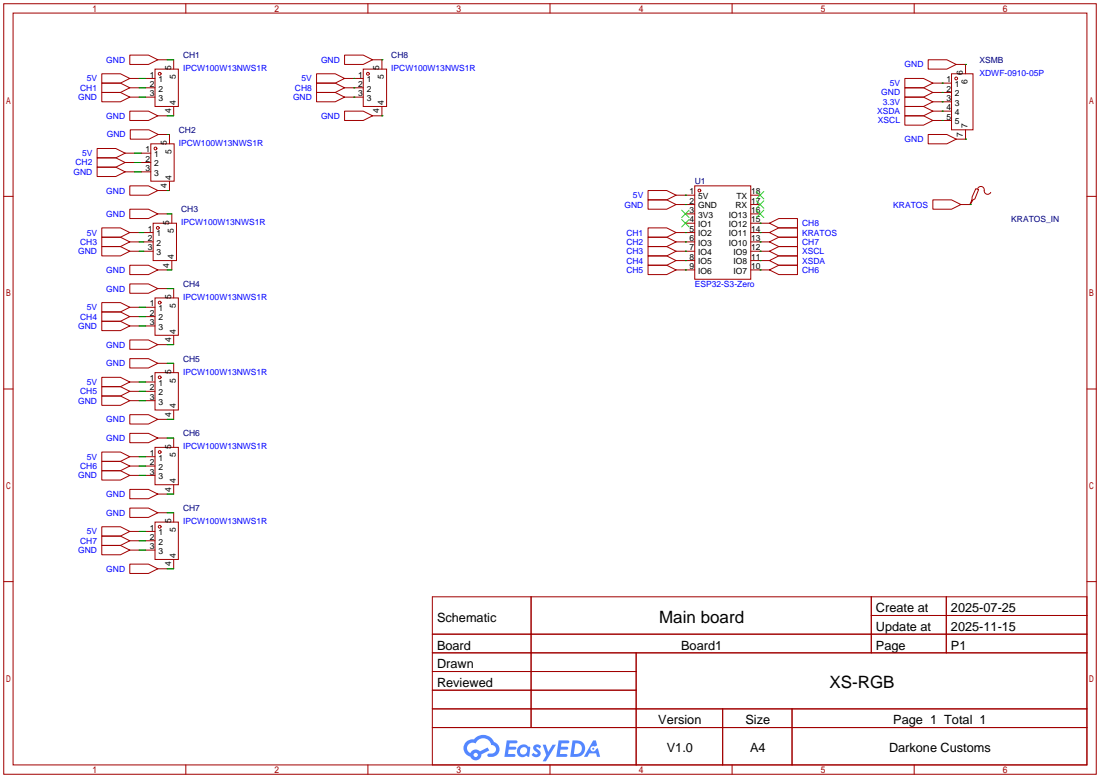
[picture p37: page 1]

Schematic | Main board | Create at | 2025-07-25

Update at | 2025-11-15

Board | Board1 | Page | P1
Drawn | | XS-RGB
Reviewed

Version | Size | Page 1 Total 1
V1.0 | A4 | Darkone Customs
