Darkone83/XBOX-RGB/src/wifimgr.cpp

#include "wifimgr.h"
#include <WiFi.h>
#include <ESPAsyncWebServer.h>
#include <Preferences.h>
#include <DNSServer.h>
#include "led_stat.h"
#include <vector>
#include <algorithm>
#include "esp_wifi.h"
#include <Update.h>  // OTA

// Single global server used by the whole project
static AsyncWebServer server(80);

namespace WiFiMgr {

static String ssid, password;
static Preferences prefs;
static DNSServer dnsServer;
static std::vector<String> lastScanResults;

enum class State { IDLE, CONNECTING, CONNECTED, PORTAL };
static State state = State::PORTAL;

static int connectAttempts = 0;
static const int maxAttempts = 10;
static unsigned long lastAttempt = 0;
static unsigned long retryDelay = 3000;

// Ensure portal routes are only added once (so we don't need server.reset()).
static bool portalRoutesAdded = false;

AsyncWebServer& getServer() {
  return server;
}

// ---------------- WiFi cred storage ----------------
static void loadCreds() {
  prefs.begin("wifi", true);
  ssid = prefs.getString("ssid", "");
  password = prefs.getString("pass", "");
  prefs.end();
}

static void saveCreds(const String& s, const String& p) {
  prefs.begin("wifi", false);
  prefs.putString("ssid", s);
  prefs.putString("pass", p);
  prefs.end();
}

static void clearCreds() {
  prefs.begin("wifi", false);
  prefs.remove("ssid");
  prefs.remove("pass");
  prefs.end();
}

// --------------- AP/Portal helpers -----------------
static void setAPConfig() {
  WiFi.softAPConfig(
    IPAddress(192, 168, 4, 1),
    IPAddress(192, 168, 4, 1),
    IPAddress(255, 255, 255, 0)
  );
}

// ===== OTA HTML (progress + client-driven reboot) =====
static const char OTA_PAGE[] PROGMEM = R"html(
<!DOCTYPE html><html><head><meta charset="utf-8">
<meta name="viewport" content="width=device-width,initial-scale=1,viewport-fit=cover">
<title>OTA Update</title>
<style>
  :root{--bg:#111;--card:#222;--ink:#EEE;--mut:#AAB;--btn:#2563eb;--ok:#2ea043;--err:#d32}
  *{box-sizing:border-box} html,body{height:100%}
  body{background:var(--bg);color:var(--ink);font-family:system-ui,Segoe UI,Roboto,Arial;margin:0}
  .wrap{min-height:100%;display:flex;align-items:center;justify-content:center;padding:env(safe-area-inset-top) 12px env(safe-area-inset-bottom)}
  .box{width:100%;max-width:520px;margin:16px auto;background:var(--card);padding:18px 16px;border-radius:12px;box-shadow:0 8px 20px #0008}
  h2{margin:0 0 12px}
  .row{display:grid;grid-template-columns:1fr;gap:10px}
  input[type=file],button{width:100%;margin:.25rem 0;padding:.7rem .8rem;border-radius:9px;border:1px solid #555;background:#111;color:var(--ink);font-size:1rem}
  button{background:var(--btn);border:0;color:#fff;cursor:pointer}
  .status{margin-top:10px;color:var(--mut)}
  .bar{height:12px;background:#0c1222;border:1px solid #334;border-radius:999px;overflow:hidden}
  .fill{height:100%;width:0%}
  .ok{background:linear-gradient(90deg,#28a745,#3ddc84)}
  .up{background:linear-gradient(90deg,#4c7cff,#7aa4ff)}
  .err{background:linear-gradient(90deg,#d32,#f55)}
  .msg{margin-top:8px;font-size:.95rem}
</style></head>
<body>
<div class="wrap">
  <div class="box">
    <h2>OTA Update</h2>
    <div class="row">
      <input id="fw" type="file" accept=".bin,.bin.gz">
      <button id="go">Upload & Flash</button>
      <div class="bar"><div id="fill" class="fill up"></div></div>
      <div id="msg" class="msg">Select a firmware <code>.bin</code> (or <code>.bin.gz</code>) and click “Upload & Flash”.</div>
      <div class="row">
        <button onclick="location.href='/'">⟵ Back to WiFi Setup</button>
        <button onclick="location.href='/config'">Open Config</button>
        <button onclick="reboot()" style="background:#a22">Reboot</button>
      </div>
      <div id="status" class="status"></div>
    </div>
  </div>
</div>
<script>
(function(){
  const fw   = document.getElementById('fw');
  const btn  = document.getElementById('go');
  const fill = document.getElementById('fill');
  const msg  = document.getElementById('msg');
  const status = document.getElementById('status');

  function setFill(p, cls){
    fill.style.width = (Math.max(0,Math.min(100,p))|0) + '%';
    fill.className = 'fill ' + (cls||'up');
  }
  function reboot(){
    fetch('/reboot',{method:'POST'}).catch(()=>0);
    setTimeout(()=>location.reload(), 2500);
  }
  function pingUntilUp(path, cb){
    let tries = 0;
    const t = setInterval(()=>{
      fetch(path, {cache:'no-store'}).then(r=>{ if (r.ok) { clearInterval(t); cb(true); } })
      .catch(()=>{});
      if (++tries > 180) { clearInterval(t); cb(false); }
    }, 1000);
  }

  btn.onclick = function(){
    const f = fw.files && fw.files[0];
    if(!f){ msg.textContent = 'Please select a firmware file first.'; return; }

    msg.textContent = 'Uploading...';
    status.textContent = '';
    setFill(0, 'up');

    const xhr = new XMLHttpRequest();
    xhr.open('POST', '/ota', true);
    xhr.responseType = 'text';

    xhr.upload.onprogress = function(ev){
      if (ev.lengthComputable) {
        const pc = ev.total ? (ev.loaded * 100 / ev.total) : 0;
        setFill(pc, 'up');
      }
    };

    xhr.onerror = function(){
      setFill(100, 'err');
      msg.textContent = 'Upload failed (network error).';
    };

    xhr.onload = function(){
      let ok = xhr.status>=200 && xhr.status<300;
      try { const j = JSON.parse(xhr.responseText||'{}'); ok = ok && !!j.ok; } catch(e){}
      if (ok) {
        setFill(100, 'ok');
        msg.textContent = 'Flashed OK. Rebooting device...';
        status.textContent = 'Waiting for device to come back online...';
        fetch('/reboot',{method:'POST'}).catch(()=>0);
        pingUntilUp('/ping', function(up){
          status.textContent = up ? 'Device is back online. You may open Config.' :
                                    'Device did not respond in time. Power-cycle if needed.';
        });
      } else {
        setFill(100, 'err');
        msg.textContent = 'Flash failed.';
        status.textContent = xhr.responseText || ('HTTP '+xhr.status);
      }
    };

    const form = new FormData();
    form.append('firmware', f, f.name);
    xhr.send(form);
  };

  window.reboot = reboot;
})();
</script>
</body></html>
)html";

// ===== OTA route registration =====
static void registerOTARoutes() {
  // Optional firmware info
  server.on("/fw", HTTP_GET, [](AsyncWebServerRequest* req){
    String v = String("TypeD/") + String(__DATE__) + " " + String(__TIME__);
    req->send(200, "text/plain", v);
  });

  // OTA page
  server.on("/ota", HTTP_GET, [](AsyncWebServerRequest* req){
    req->send_P(200, "text/html", OTA_PAGE);
  });

  // OTA upload/flash (streamed), JSON reply; client triggers /reboot
  server.on(
    "/ota",
    HTTP_POST,
    [](AsyncWebServerRequest* request){
      const bool ok = !Update.hasError();
      if (ok) {
        String msg = "{\"ok\":true,\"bytes\":" + String(Update.progress()) + "}";
        request->send(200, "application/json", msg);
        Serial.println("[OTA] Update uploaded OK; client will reboot device.");
      } else {
        request->send(500, "application/json", "{\"ok\":false}");
        Serial.println("[OTA] Update failed.");
      }
    },
    [](AsyncWebServerRequest* request, String filename, size_t index, uint8_t* data, size_t len, bool final){
      if (index == 0) {
        Serial.printf("[OTA] Starting: %s\n", filename.c_str());
        if (!Update.begin(UPDATE_SIZE_UNKNOWN)) {
          Update.printError(Serial);
        }
      }
      if (len) {
        if (Update.write(data, len) != len) {
          Update.printError(Serial);
        }
      }
      if (final) {
        if (!Update.end(true)) {
          Update.printError(Serial);
        } else {
          Serial.printf("[OTA] Finished: %u bytes\n", (unsigned)(index + len));
        }
      }
    }
  );

  // Reboot endpoint (client calls this after success)
  server.on("/reboot", HTTP_POST, [](AsyncWebServerRequest* req){
    req->send(200, "text/plain", "Rebooting...");
    Serial.println("[OTA] Reboot requested");
    auto t = millis() + 300; while (millis() < t) { delay(1); }
    ESP.restart();
  });
  server.on("/reboot", HTTP_GET, [](AsyncWebServerRequest* req){
    req->send(200, "text/plain", "Rebooting...");
    Serial.println("[OTA] Reboot requested (GET)");
    auto t = millis() + 300; while (millis() < t) { delay(1); }
    ESP.restart();
  });
}

static void addPortalRoutesOnce() {
  if (portalRoutesAdded) return;
  portalRoutesAdded = true;

  // Small ping endpoint we can use to probe device reachability
  server.on("/ping", HTTP_GET, [](AsyncWebServerRequest *request){
    AsyncWebServerResponse* resp = request->beginResponse(200, "text/plain", "ok");
    resp->addHeader("Cache-Control", "no-store");
    request->send(resp);
  });

  // ⬇️ Add OTA routes (available in AP/STA)
  registerOTARoutes();

  // ---------- Portal UI ----------
  server.on("/", HTTP_GET, [](AsyncWebServerRequest *request){
    String page = R"HTML(
<!DOCTYPE html>
<html>
<head>
  <title>WiFi Setup</title>
  <meta name="viewport" content="width=device-width,initial-scale=1,viewport-fit=cover">
  <style>
    :root{--bg:#111;--card:#222;--ink:#EEE;--mut:#AAB;--pri:#299a2c;--warn:#a22;--link:#9ec1ff}
    *{box-sizing:border-box}
    html,body{height:100%}
    body {background:var(--bg);color:var(--ink);font-family:system-ui,Segoe UI,Roboto,Arial;margin:0}
    .wrap{min-height:100%;display:flex;align-items:center;justify-content:center;padding:env(safe-area-inset-top) 12px env(safe-area-inset-bottom)}
    .container {width:100%;max-width:420px;margin:16px auto;background:var(--card);padding:16px;border-radius:12px;box-shadow:0 8px 20px #0008;}
    h1 {margin:0 0 .6em; font-size:1.6em}
    label{display:block;margin-top:8px;color:var(--mut);font-size:.95em}
    input,select,button {width:100%;margin:.5em 0;padding:.75em .8em;font-size:1em;border-radius:9px;border:1px solid #555;background:#111;color:var(--ink)}
    button{cursor:pointer}
    .btn-primary {background:var(--pri);border:0;color:white}
    .btn-danger {background:var(--warn);border:0;color:white}
    .btn-ota {background:#265aa5;border:0;color:white}
    .btn-config {background:#7a3ef0;border:0;color:white}
    .row {display:grid;grid-template-columns:1fr;gap:.6em}
    .status {margin-top:8px;opacity:.9;font-size:.95em}
    .links{display:flex;gap:8px;flex-wrap:wrap}
    .links a{color:var(--link);text-decoration:none}
  </style>
</head>
<body>
  <div class="wrap">
  <div class="container">
    <h1>XBOX RGB Setup</h1>
    <div class="row">
      <label>WiFi Network</label>
      <select id="ssidDropdown">
        <option value="">Scanning...</option>
      </select>
      <input type="text" id="ssid" placeholder="SSID">
      <label>Password</label>
      <input type="password" id="pass" placeholder="WiFi Password">
      <button type="button" onclick="save()" class="btn-primary">Connect & Save</button>
      <button type="button" onclick="forget()" class="btn-danger">Forget WiFi</button>
      <div class="links">
        <button type="button" onclick="window.location='/ota'" class="btn-ota">OTA Update</button>
        <button type="button" onclick="window.location='/config'" class="btn-config">Open Config</button>
      </div>
      <div class="status" id="status">Status: ...</div>
    </div>
  </div>
  </div>
<script>
  function scan() {
    fetch('/scan',{cache:'no-store'}).then(r => r.json()).then(list => {
      let dd = document.getElementById('ssidDropdown');
      dd.innerHTML = '';
      let def = document.createElement('option');
      def.value = '';
      def.text = list.length ? 'Please select a network' : 'No networks found';
      dd.appendChild(def);
      list.forEach(name => {
        let opt = document.createElement('option');
        opt.value = name;
        opt.text = name;
        dd.appendChild(opt);
      });
      dd.onchange = function(){ document.getElementById('ssid').value = dd.value; };
    }).catch(() => {
      let dd = document.getElementById('ssidDropdown');
      dd.innerHTML = '';
      let opt = document.createElement('option');
      opt.value = '';
      opt.text = 'Scan failed';
      dd.appendChild(opt);
    });
  }
  setInterval(scan, 3000);
  window.onload = scan;

  function save() {
    let ssid = document.getElementById('ssid').value;
    let pass = document.getElementById('pass').value;
    fetch('/save',{
      method:'POST',
      headers:{'Content-Type':'application/json','Cache-Control':'no-store'},
      body:JSON.stringify({ssid:ssid,pass:pass})
    }).then(r=>r.text()).then(t=>{ document.getElementById('status').innerText=t; }).catch(()=>{
      document.getElementById('status').innerText='Error sending credentials';
    });
  }
  function forget() {
    fetch('/forget',{cache:'no-store'}).then(r=>r.text()).then(t=>{
      document.getElementById('status').innerText=t;
      document.getElementById('ssid').value='';
      document.getElementById('pass').value='';
    });
  }
</script>
</body>
</html>
)HTML";
    AsyncWebServerResponse* resp = request->beginResponse(200, "text/html", page);
    resp->addHeader("Cache-Control", "no-store");
    request->send(resp);
  });

  // ---------- WiFi status ----------
  server.on("/status", HTTP_GET, [](AsyncWebServerRequest *request){
    String stat;
    if (WiFi.status() == WL_CONNECTED)
      stat = "Connected to " + WiFi.SSID() + " - IP: " + WiFi.localIP().toString();
    else if (state == State::CONNECTING)
      stat = "Connecting to " + ssid + "...";
    else
      stat = "In portal mode";
    AsyncWebServerResponse* resp = request->beginResponse(200, "text/plain", stat);
    resp->addHeader("Cache-Control", "no-store");
    request->send(resp);
  });

  // ---------- Connect (GET) ----------
  server.on("/connect", HTTP_GET, [](AsyncWebServerRequest *request){
    String ss, pw;
    if (request->hasParam("ssid")) ss = request->getParam("ssid")->value();
    if (request->hasParam("pass")) pw = request->getParam("pass")->value();
    if (ss.length() == 0) {
      request->send(400, "text/plain", "SSID missing");
      return;
    }
    saveCreds(ss, pw);
    ssid = ss; password = pw;
    state = State::CONNECTING;
    connectAttempts = 1;
    WiFi.mode(WIFI_AP_STA);
    delay(100);
    WiFi.begin(ssid.c_str(), password.c_str());
    AsyncWebServerResponse* resp = request->beginResponse(200, "text/plain", "Connecting to: " + ssid);
    resp->addHeader("Cache-Control", "no-store");
    request->send(resp);
  });

  // ---------- Save creds (POST JSON body) ----------
  server.on("/save", HTTP_POST,
    [](AsyncWebServerRequest *request){},
    NULL,
    [](AsyncWebServerRequest *request, uint8_t *data, size_t len, size_t, size_t) {
      String body; body.reserve(len ? len : 64);
      for (size_t i=0;i<len;i++) body += (char)data[i];
      // crude parse: {"ssid":"...","pass":"..."}
      int ssidStart = body.indexOf("\"ssid\":\"") + 8;
      int ssidEnd   = body.indexOf("\"", ssidStart);
      int passStart = body.indexOf("\"pass\":\"") + 8;
      int passEnd   = body.indexOf("\"", passStart);
      String newSsid = (ssidStart >= 8 && ssidEnd > ssidStart) ? body.substring(ssidStart, ssidEnd) : "";
      String newPass = (passStart >= 8 && passEnd > passStart) ? body.substring(passStart, passEnd) : "";
      if (newSsid.length() == 0) {
        request->send(400, "text/plain", "SSID missing");
        return;
      }
      saveCreds(newSsid, newPass);
      ssid = newSsid; password = newPass;
      state = State::CONNECTING;
      connectAttempts = 1;
      WiFi.begin(newSsid.c_str(), newPass.c_str());
      AsyncWebServerResponse* resp = request->beginResponse(200, "text/plain", "Connecting to: " + newSsid);
      resp->addHeader("Cache-Control", "no-store");
      request->send(resp);
      Serial.printf("[WiFiMgr] Received new creds. SSID: %s\n", newSsid.c_str());
    }
  );

  // ---------- Scan: return de-duped, RSSI-sorted names ----------
  server.on("/scan", HTTP_GET, [](AsyncWebServerRequest *request){
    int n = WiFi.scanComplete();

    // Start async scan if not running yet
    if (n == -2) {
      // async=true, show_hidden=true (passive=false keeps it quick)
      WiFi.scanNetworks(true, true);
    }

    if (n >= 0) {
      struct Net { String name; int32_t rssi; };
      std::vector<Net> nets;
      nets.reserve(n);

      // Build unique set by SSID, keep strongest RSSI
      for (int i = 0; i < n; ++i) {
        String name = WiFi.SSID(i);
        if (!name.length()) continue; // ignore hidden/empty SSIDs
        int32_t rssi = WiFi.RSSI(i);

        bool merged = false;
        for (auto &it : nets) {
          if (it.name == name) {
            if (rssi > it.rssi) it.rssi = rssi;
            merged = true;
            break;
          }
        }
        if (!merged) nets.push_back({name, rssi});
      }

      // sort by strongest first
      std::sort(nets.begin(), nets.end(), [](const Net& a, const Net& b){ return a.rssi > b.rssi; });

      lastScanResults.clear();
      lastScanResults.reserve(nets.size());
      for (auto &it : nets) lastScanResults.push_back(it.name);

      WiFi.scanDelete();
      // Immediately kick off a new async scan so results stay fresh
      WiFi.scanNetworks(true, true);
    }

    // Return cached (or just-updated) names only
    String json = "[";
    for (size_t i=0; i<lastScanResults.size(); ++i) {
      if (i) json += ",";
      json += "\"" + lastScanResults[i] + "\"";
    }
    json += "]";
    AsyncWebServerResponse* resp = request->beginResponse(200, "application/json", json);
    resp->addHeader("Cache-Control", "no-store");
    request->send(resp);
  });

  // ---------- Forget ----------
  server.on("/forget", HTTP_GET, [](AsyncWebServerRequest *request){
    clearCreds();
    ssid = ""; password = "";
    WiFi.disconnect();
    state = State::PORTAL;
    AsyncWebServerResponse* resp = request->beginResponse(200, "text/plain", "WiFi credentials cleared.");
    resp->addHeader("Cache-Control", "no-store");
    request->send(resp);
  });

  // ---------- Captive portal helpers ----------
  auto cp = [](AsyncWebServerRequest *r){
    AsyncWebServerResponse* resp = r->beginResponse(200, "text/html", "<meta http-equiv='refresh' content='0; url=/' />");
    resp->addHeader("Cache-Control", "no-store");
    r->send(resp);
  };
  server.on("/generate_204", HTTP_GET, cp);
  server.on("/hotspot-detect.html", HTTP_GET, cp);
  server.on("/redirect", HTTP_GET, cp);
  server.on("/ncsi.txt", HTTP_GET, cp);
  server.on("/captiveportal", HTTP_GET, cp);
  server.onNotFound(cp);

  // No caching for UI/API
  DefaultHeaders::Instance().addHeader("Cache-Control", "no-store");
}

static void startPortal() {
  WiFi.disconnect(true);
  delay(100);
  setAPConfig();
  WiFi.mode(WIFI_AP_STA);  // AP+STA so scan works while in portal
  delay(100);

  // Channel 6 for iOS compatibility
  bool apok = WiFi.softAP("XBOX RGB Setup", "", 6, 0);
  esp_wifi_set_max_tx_power(20);
  LedStat::setStatus(LedStatus::Portal);
  Serial.printf("[WiFiMgr] softAP=%d, IP: %s\n", apok, WiFi.softAPIP().toString().c_str());
  delay(200);

  IPAddress apIP = WiFi.softAPIP();
  dnsServer.start(53, "*", apIP);

  // Do NOT reset the server: keep previously-registered routes (like /config) live in AP mode.
  addPortalRoutesOnce();

  server.begin();
  state = State::PORTAL;

  // Kick off an initial async scan
  WiFi.scanNetworks(true, true);
}

static void stopPortal() {
  dnsServer.stop();
}

static void tryConnect() {
  if (ssid.length() > 0) {
    WiFi.mode(WIFI_AP_STA);
    delay(100);
    WiFi.begin(ssid.c_str(), password.c_str());
    state = State::CONNECTING;
    connectAttempts = 1;
    lastAttempt = millis();
  } else {
    startPortal();
  }
}

// ---------------- Public API ----------------
void begin() {
  LedStat::setStatus(LedStatus::Booting);
  loadCreds();
  startPortal();    // always start captive portal
  if (ssid.length() > 0) {
    tryConnect();   // attempt STA connect in background
  }
}

void loop() {
  dnsServer.processNextRequest();

  if (state == State::CONNECTING) {
    if (WiFi.status() == WL_CONNECTED) {
      state = State::CONNECTED;
      dnsServer.stop();
      Serial.println("[WiFiMgr] WiFi connected.");
      Serial.print("[WiFiMgr] IP Address: ");
      Serial.println(WiFi.localIP());
      LedStat::setStatus(LedStatus::WifiConnected);
    } else if (millis() - lastAttempt > retryDelay) {
      connectAttempts++;
      if (connectAttempts >= maxAttempts) {
        state = State::PORTAL;
        startPortal();
        LedStat::setStatus(LedStatus::WifiFailed);
      } else {
        WiFi.disconnect();
        WiFi.begin(ssid.c_str(), password.c_str());
        lastAttempt = millis();
      }
    }
  }
}

void restartPortal() {
  startPortal();
}

void forgetWiFi() {
  clearCreds();
  startPortal();
}

bool isConnected() {
  return WiFi.status() == WL_CONNECTED;
}

String getStatus() {
  if (isConnected()) return "Connected to: " + ssid;
  if (state == State::CONNECTING) return "Connecting to: " + ssid;
  return "Not connected";
}

} // namespace WiFiMgr
