Darkone83/XBOX-RGB/(commit log)

2025-08-27 Initial Upload
    [BOM.xlsx, PickAndPlace.xlsx]
2025-09-27 SMBUS and OTA Patched
    Further hardened smbus scanning to prevent smbus clash. Re-worked OTA updater.
    [RGBCtrl.cpp, RGBsmbus.cpp, RGBudp.cpp, RGBudp.h, XBOX_RGB.ino, led_stat.cpp, wifimgr.cpp]
2025-10-14 Wiring corrections
2025-10-14 Intall images / STL
    [RGB Mount v0.stl]
2025-11-16 1.7.2 Halo Update
    Added additional animations, support for the Jewel ROL, and pre-planed for future expansions
    [BOM.xlsx, PickAndPlace.xlsx]
2025-11-16 1.8.0 BLE Edition
    [BOM.xlsx, PickAndPlace.xlsx]
2025-11-21 Update XBOX RGB Install.pdf
    Added instructions for V3 boards and connecting ROL to legacy boards
